raphaelPinheiro26/tt_um_fp8_fpu/README.md

# FP8 (E4M3) Floating-Point Unit — Tiny Tapeout

An 8-bit IEEE-style FPU: **18 operations, five rounding modes, full IEEE flags
and exceptions**, in 1×2 tiles of ChipFoundry `sky130A`.

<p align="center">
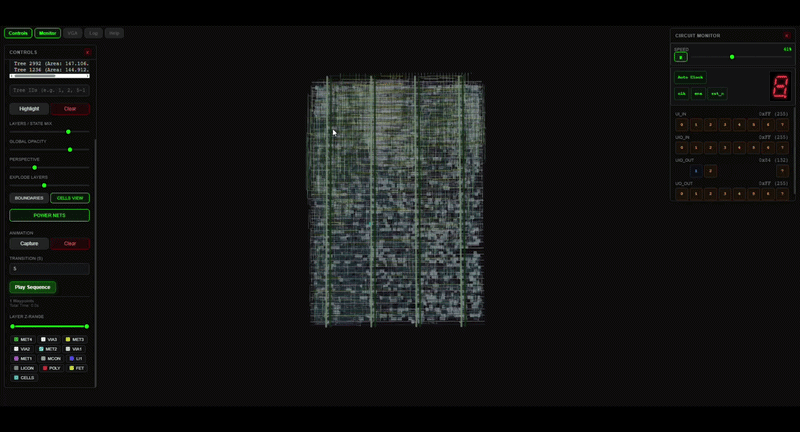
[picture p1: docs/assets/gds-3d-viewer.gif]
Layer-by-layer walkthrough of the hardened GDS — standard cells, li1 local interconnect, met1 to met4 routing
  
</p>

**Every possible input is tested.** All 1,843,968 combinations of operands,
opcode and rounding mode are replayed against an exact reference model — at RTL
*and* against the post-place-and-route netlist. Nothing is sampled.

That is not achievable in wider formats: a binary FP32 operation has 2⁶⁴ input
combinations, which is why floating-point hardware is normally verified by
theorem proving instead. In a minifloat, exhaustive enumeration comes back
within reach — and it is what made it safe to cut the datapath widths to their
proven floor while adding four new operations.

<p align="center">
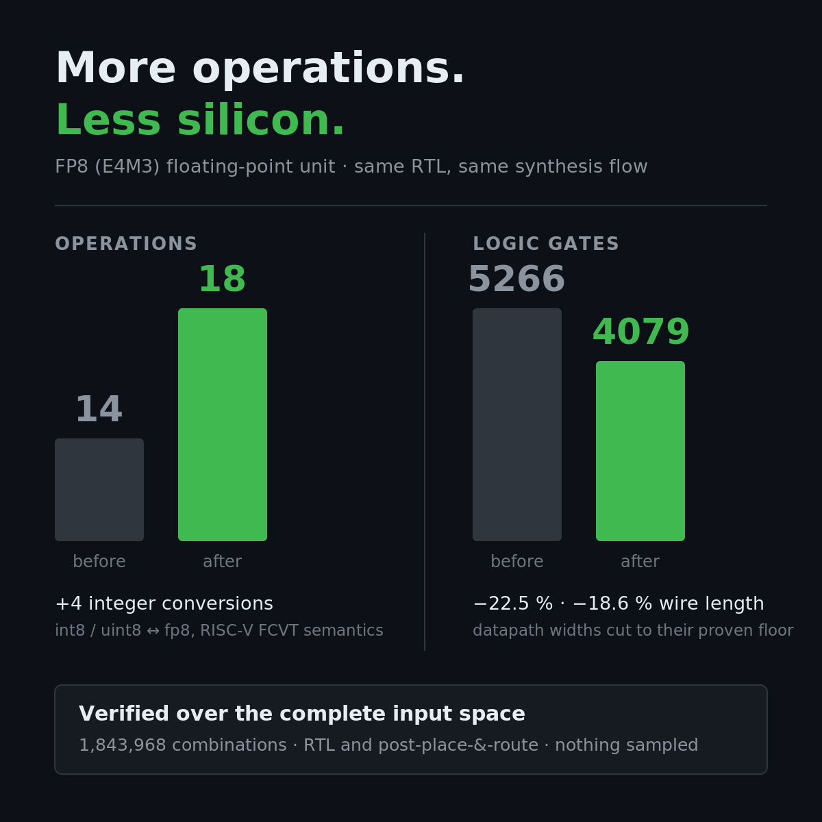
[picture p2: docs/assets/ops-vs-area.png]
More operations, less silicon: 14 to 18 operations while logic gates fell from 5266 to 4079
  
</p>

| | |
|---|---|
| Format | FP8 E4M3 — 1 sign, 4 exponent (bias 7), 3 mantissa |
| Operations | add · sub · mul · div · sqrt · min · max · abs · classify · compare · scalb · roundToIntegral · neg · copySign · **int8/uint8 ↔ fp8** |
| Process | `sky130A` 1×2 tiles — earlier `gf180mcu` 2×2 hardening run (local) |
| Utilisation | 71.6 %, **0** detailed-routing violations |
| Timing | reg-to-reg critical path **15.8 ns** at the slow corner (~63 MHz of datapath headroom) |
| Power | ≈ 2.3 mW |
| Verification | **1 843 968 vectors, exhaustive, RTL and gate level** |

---

## Documentation

Everything lives in the **[Wiki](../../wiki)** — this file is only the front
door.

| | |
|---|---|
| 🗂 [Project Structure](../../wiki/Project-Structure) | What every folder and file is for. **Start here if you cloned this.** |
| 🚀 [Getting Started](../../wiki/Getting-Started) · [End-to-End Setup](../../wiki/End-to-End-Setup) | Toolchain, simulation, verification, hardening |
| 📖 [Floating-Point Primer](../../wiki/Floating-Point-Primer) | How floating point works and why E4M3 — from first principles |
| 🏗 [Architecture](../../wiki/Design-Architecture) | Elastic datapath and how the Tiny Tapeout wrapper works |
| 📐 [ISA Reference](../../wiki/ISA-Reference) · [Pin Protocol](../../wiki/Pin-Protocol) | Encoding, flags, exceptions, cycle-by-cycle protocol |
| 🤔 [Design Decisions](../../wiki/Design-Decisions) | Every non-obvious choice, the rejected alternative, and why — including what turned out wrong |
| ✅ [Coverage & Sign-off](../../wiki/Coverage-and-Signoff) | What is proven, how, and what is not |
| 📊 [Results & Metrics](../../wiki/Results-and-Metrics) | Area, timing and power, broken down by the change that produced them |
| 🔌 [RISC-V Integration](../../wiki/RISC-V-Integration) | Attaching the core to CV32E40X (XIF) or PicoRV32 (PCPI), with code |

## Quick start

```sh
# 1. reference vectors
cd Golden_model
python3 gen_vectors_math.py          # -> vectors.hex         (1 311 488)
python3 gen_vectors_math.py --new    # -> vectors_newops.hex  (  527 360)
python3 gen_vectors_math.py --cvt    # -> vectors_cvt.hex     (    5 120)

# 2. full sign-off, every opcode, every input
cd ../test
JOBS=$(nproc) ./regress.sh                    # RTL
GATES=yes JOBS=$(nproc) ./regress.sh          # post-PnR netlist
```

Expected last line: `ALL PASS`.

## Repository layout

```
src/            synthesizable RTL (this is what becomes silicon)
Golden_model/   exact Python reference model + vector generator
test/           top-level sign-off (cocotb) + regress.sh
sim/            block-level testbenches
verification/   formal (SymbiYosys), UVM (pyuvm), DFT
flow/           area/timing/power extraction from the hardening run
docs/wiki/      all documentation — published to the GitHub Wiki
```

Annotated version, with the role of every file:
**[Project Structure](../../wiki/Project-Structure)**.

## License

Apache-2.0 — see [LICENSE](LICENSE).
