raphaelPinheiro26/tt_um_fp8_fpu/docs/wiki/_Sidebar.md

### FP8 E4M3 FPU

- [Home](Home)

**Start here**
- [Project Structure](Project-Structure)
- [Getting Started](Getting-Started)
- [End-to-End Setup](End-to-End-Setup)
- [Tools Cheatsheet](Tools-Cheatsheet)

**Concepts**
- [Floating-Point Primer](Floating-Point-Primer)

**Design**
- [Architecture](Design-Architecture)
- [ISA Reference](ISA-Reference)
- [Pin Protocol](Pin-Protocol)
- [Design Decisions](Design-Decisions)

**Verification**
- [Coverage & Sign-off](Coverage-and-Signoff)
- [Simulation & Tests](Simulation-and-Tests)
- [Formal (SymbiYosys)](Verification-Formal)
- [UVM (pyuvm)](Verification-UVM)
- [DFT](Verification-DFT)

**Physical**
- [Results & Metrics](Results-and-Metrics)
- [Hardening](Hardening-and-Metrics)
- [Area Runbook](Area-Runbook)
- [Timing Study](Timing-Study)
- [Combinational Optimization](Combinational-Optimization)

**Using it**
- [RISC-V Integration](RISC-V-Integration)
